mathiasekse/IELS2003_PCB/Rapport/Bilder/transmissjonslinje.jpg

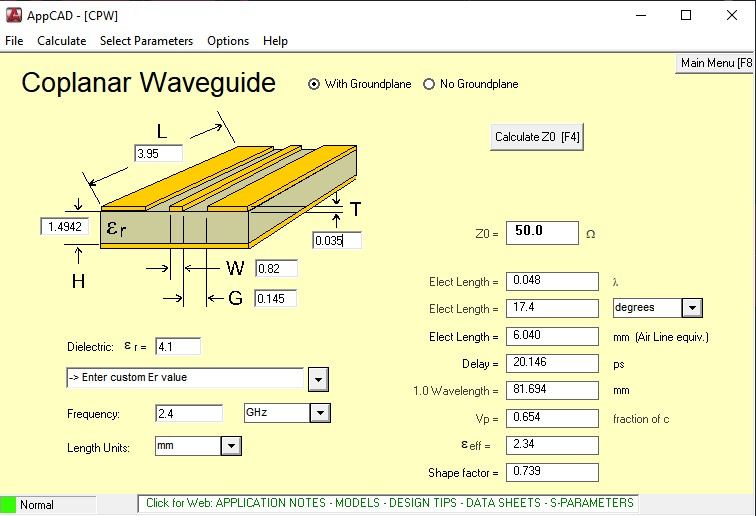
Rapport/Bilder/transmissjonslinje.jpg
