mathiasekse/IELS2003_PCB/nRF_beacon/BOM_nRF_AUDIO_BEACON.xlsx

Sheet: Grocery list
 |  |  |  |  |  |  |  |  |  | BATTERY HOLDER TOTAL
BOM |  | nRF54 BLE BEACON |  |  |  | Prosjektgruppe 15
DONE | Reference Designator | Part Number | Value | Component type | QTY | Footprint size | UNIT PRICE | TOTAL | COMMENT |  | PASSIVE TOTAL
 | C1,C6 | GRM033D80E225ME47D | 2.2 uF | PASSIVE | 2 | 0201 | kr 1.10 | kr 2.20 | Kondensator |  | kr 124.00
 | C2 | KGM05CS60J106MH | 10 uF | PASSIVE | 1 | 0402 | kr 3.19 | kr 3.19 | Kondensator
 | C3 | GRM033R70J103JA01D | 10 nF | PASSIVE | 1 | 0201 | kr 1.00 | kr 1.00 | Kondensator |  | IC TOTAL
 | C4,C8,C9,C10 | KGM03AR70J104KH | 100 nF | PASSIVE | 4 | 0201 | kr 3.60 | kr 14.40 | Kondensator |  | kr 90.00
 | C5 | GRM033R71A222KA01D | 2.2 nF | PASSIVE | 1 | 0201 | kr 1.00 | kr 1.00 | Kondensator
 | C7 | GCQ0335C1H3R9CB01D | 3.9 pF | PASSIVE | 1 | 0201 | kr 1.19 | kr 1.19 | Kondensator |  | SPEAKER TOTAL
 | C11 | GJM0335C1E1R5WB01J | 1.5 pF | PASSIVE | 1 | 0201 | kr 1.00 | kr 1.00 | Kondensator |  | kr 47.00
 | C12 | GJM0335C1E2R0WB01D | 2.0 pF | PASSIVE | 1 | 0201 | kr 1.19 | kr 1.19 | Kondensator
 | C13 | GCQ0335C1HR30BB01D | 0.3 pF | PASSIVE | 1 | 0201 | kr 1.19 | kr 1.19 | Kondensator |  | BATTERY HOLDER TOTAL
 | C14,C16,C17,C23,C24,C25 | KGM15CR51E106KT | 10 uF | PASSIVE | 6 | 0603 | kr 5.09 | kr 30.54 | Kondensator |  | kr 38.00
 | C15 | GRM188Z71C225KE43D | 2.2 uF | PASSIVE | 1 | 0603 | kr 1.60 | kr 1.60 | Kondensator
 | C18,C21,C22 | KGM03BR51E104KH | 0.1 uF | PASSIVE | 3 | 0201 | kr 1.39 | kr 4.17 | Kondensator |  | CONNECTOR TOTAL
 | C19,C20 | C0603C221J5RACTM | 220 pF | PASSIVE | 2 | 0603 | kr 1.30 | kr 2.60 | Kondensator |  | kr 21.00
 | C26 | GCQ0335C1H1R4WB01D | 1.4 pF | PASSIVE | 1 | 0201 | kr 1.80 | kr 1.80 | Kondensator
 | D1 | APGF1012GBRC-07 | LED_RGBA | PASSIVE | 1 | 1012 | kr 11.37 | kr 11.37 | LED |  | COMPONENTS TOTAL
 | FB1 | MMZ0603Y121CT000 | 120 | PASSIVE | 1 | 0201 | kr 1.30 | kr 1.30 | Ferrite Bead |  | kr 321.00
 | FB2,FB3 | BLM21SP102SN1D | 1000 | PASSIVE | 2 | 0805 | kr 2.99 | kr 5.98 | Ferrite Bead
 | J1 | FTSH-105-01-F-DV-K-P | Conn_02x05_Odd_Even | CONNECTOR | 1 | 105 | kr 21.00 | kr 21.00 | Konnektor
 | J2 |  | Conn_02x03_Counter_Clockwise |  | 1 | P2.54mm |  | kr 0.00 | Konnektor
 | L1 | LQM18PN4R7MFRL | 4.7uH | PASSIVE | 1 | 0603 | kr 1.69 | kr 1.69 | Spole
 | L2 | LQP03HQ2N7B02D | 2.7nH | PASSIVE | 1 | 0201 | kr 1.19 | kr 1.19 | Spole
 | L3,L4 | LQP03HQ3N5B02D | 3.5nH | PASSIVE | 2 | 0201 | kr 1.19 | kr 2.38 | Spole
 | L5,L6 | MLP2016V2R2MT0S1 | 2.2uH | PASSIVE | 2 | 2016 | kr 2.19 | kr 4.38 | Spole
 | LS1 | AS07104PO-R | AS07104PO-R | SPEAKER | 1 | 71x41x25mm | kr 47.21 | kr 47.21 | Høyttaler
 | R1 | CRCW0603634KDHTAP | 634k | PASSIVE | 1 | 0603 | kr 3.89 | kr 3.89 | Resistor
 | R2 | RCA02011K00FNEDSR | 1k | PASSIVE | 1 | 0201 | kr 1.00 | kr 1.00 | Resistor
 | R3,R4 | CRCW040210K0FHEDP | 10k | PASSIVE | 2 | 0402 | kr 3.19 | kr 6.38 | Resistor
 | R5,R6 | CRCW0201150KFKED | 150k | PASSIVE | 2 | 0201 | kr 2.10 | kr 4.20 | Resistor
 | U1 | NRF54L15-QFAA-R7 | nRF54L15-QFAA | IC | 1 | 6x6mm P0.4mm | kr 23.08 | kr 23.08 | MCU
 | U2 | NPM1300-QEAA-R7 | NPM1300-QEAA-R7 | IC | 1 | 5x5mm P0.5mm | kr 15.31 | kr 15.31 | PMIC
 | U3 | MAX98357AETE+T | MAX98357A | IC | 1 | 3x3mm P0.5mm | kr 51.62 | kr 51.62 | Audio DAC + Forsterker
 | U4 | 12BHC186P1-GR | 12BHC186P1-GR | BATTERY HOLDER | 1 | 12 | kr 38.28 | kr 38.28 | Batteriholder
 | X1 | CX2016DB32000D0WZRC1 | 32MHz | PASSIVE | 1 | 2016 | kr 6.59 | kr 6.59 | Krystall
 | X2 | CM8V-T1A-32.768kHz-9pF-20PPM-TB-QC | 32.768 kHz | PASSIVE | 1 | 2012-2Pin | kr 6.59 | kr 6.59 | Krystall

Sheet: calculations
*** Sheet to remain hidden ***
 |  |  |  |  |  |  | kr 0.00 | kr 0.00 | OTHER TOTAL
 |  |  |  |  |  |  |  | kr 321.00 | COMPONENTS TOTAL
 | PASSIVE | 124.002 | 124.002006 | 124.002006 | 1 | PASSIVE | kr 124.00 | kr 124.00 | PASSIVE TOTAL
 | CONNECTOR | 21 | 21.000007 | 90.01001 | 5 | IC | kr 90.01 | kr 90.00 | IC TOTAL
 | 0 | 0 | 8e-06 | 47.210009 | 4 | SPEAKER | kr 47.21 | kr 47.00 | SPEAKER TOTAL
 | SPEAKER | 47.21 | 47.210009 | 38.280011 | 6 | BATTERY HOLDER | kr 38.28 | kr 38.00 | BATTERY HOLDER TOTAL
 | IC | 90.01 | 90.01001 | 21.000007 | 2 | CONNECTOR | kr 21.00 | kr 21.00 | CONNECTOR TOTAL
 | BATTERY HOLDER | 38.28 | 38.280011 | 2.1e-05 | 16 |  | kr 0.00
 |  | 0 | 1.2e-05
 |  | 0 | 1.3e-05
 |  | 0 | 1.4e-05
 |  | 0 | 1.5e-05
 |  | 0 | 1.6e-05
 |  | 0 | 1.7e-05
 |  | 0 | 1.8e-05
 |  | 0 | 1.9e-05
 |  | 0 | 2e-05
 |  | 0 | 2.1e-05
