mathiasekse/IELS2003_PCB/symbols_footprints/nPM1300-QEAA-Reference-Layout-1_2/Bill of Materials/npm1300_qeaa_config2_bom.xlsx

Bill of Materials
Device: | nPM1300-QEAA
Configuration No.: | 2
Reference Layout Title: | Simple – one BUCK, LOADSW and LED
Revision: | 1.2
Creation Date: | 2025-06-05
Designator | Value | Description | Footprint Doc | Manufacturer | Manufacturer Part Number | #Column Name Error:' Fitted | Quantity
C1, C5, C14 | 1.0µF | Capacitor, Ceramic, 1.0µF 10V X5R 0603,±10% | 0603 | N.A. | N.A. |  | 3
C2, C4, C7 | 10µF | Capacitor, Ceramic, X5R, ±20%, 10V | 0603 | N.A. | N.A. |  | 3
C6 | 2.2µF | Capacitor, Ceramic, X5R, ±10%, 25V | 0603 | Murata | GRM188R61E225KA12D |  | 1
C13 | 100nF | Capacitor, Ceramic, X5R, ±10%, 25V | 0201 | Murata | GRM033R61E104KE14J |  | 1
L1 | 2.2µH | Inductor, Irms=2.5A, Isat=2.9A, ±20%, DCR=73mΩ | 0806 | Samsung Electro-Mechanics America | CIGT201610EH2R2MNE |  | 1
R1, R2 | 10k | Resistor, ±1%, 0.05W | 0201 | N.A. | N.A. |  | 2
R3 | 47k | Resistor, ±1%, 0.05W | 0201 | N.A. | N.A. |  | 1
U1 | nPM1300-QEAA | Li-Ion/Li-Polymer USB-C battery charger with high efficiency buck regulators, LDOs or load switches, LED drivers, TWI and VBUSOUT | QFN-32 | Nordic Semiconductor | nPM1300-QEAA |  | 1
 |  |  |  |  |  |  | 13
