mathiasekse/IELS2003_PCB/symbols_footprints/nPM1300-QEAA-Reference-Layout-1_2/Bill of Materials/npm1300_qeaa_config3_bom.xlsx

Bill of Materials
Device: | nPM1300-QEAA
Configuration No.: | 3
Reference Layout Title: | Minimal – only battery charging and VSYS output
Revision: | 1.2
Creation Date: | 2025-06-05
Designator | Value | Description | Footprint Doc | Manufacturer | Manufacturer Part Number | #Column Name Error:' Fitted | Quantity
C1, C5 | 1.0µF | Capacitor, Ceramic, 1.0µF 10V X5R 0603,±10% | 0603 | N.A. | N.A. |  | 2
C4 | 10µF | Capacitor, X5R, ±20% | 0603 | N.A. | N.A. |  | 1
C6 | 2.2µF | Capacitor, Ceramic, X7R, ±10%, 16V | 0603 | Taiyo Yuden | EMK107BB7225KA-T |  | 1
C13 | 100nF | Capacitor, X5R, ±10%, 100nF, 16V | 0201 | N.A. | N.A. |  | 1
R1, R2 | 10k | Resistor, ±1%, 0.05W | 0201 | N.A. | N.A. |  | 2
U1 | nPM1300-QEAA | Li-Ion/Li-Polymer USB-C battery charger with high efficiency buck regulators, LDOs or load switches, LED drivers, TWI and VBUSOUT | QFN-32 | Nordic Semiconductor | nPM1300-QEAA |  | 1
 |  |  |  |  |  |  | 8
