mathiasekse/IELS2003_PCB/symbols_footprints/nrf54l15-qfaa-reference-layout-0_8/nRF54L15-QFAA Reference Layout 0_8/Bill of Materials/nRF54L15_qfaa_4L_config1_bom.xls

Bill of material
Device: | nRF54L15-QFAA
Title: | Reference Layout
Version: | v0.8
Designator | Value | Description | Assembly | Footprint Doc
C1, C2 | 2.2µF | Capacitor, Ceramic, 2.2µF 2.5V X6T 0201,±20% |  | 0201
C3 | 10µF | Capacitor, X6S, ±20%, 6.3V |  | 0402
C4, C7, C8, C10 | 100nF | Capacitor, X7R, ±10% |  | 0201
C5 | 2.2nF | Capacitor, X7R, ±10%, 10V |  | 0201
C6 | 1.5pF | Capacitor, NP0, ±0.05pF, 25V |  | 0201
C9 | 2.0pF | Capacitor, NP0, ±0.05pF, 25V |  | 0201
C11 | 0.3pF | Capacitor, C0G, ±0.1pF, 50V |  | 0201
C12 | 10nF | Capacitor, X7R, 6.3V |  | 0201
C13 | 3.9pF | Capacitor, NP0, ±0.05pF, 25V |  | 0201
FB1 | 120R/0.2A | Ferrite Bead, 120 Ohm @ 100MHz, 200mA, 500 mOhm Max |  | 0201
L1 | 4.7µH | Inductor, 120mA, ±20%, 0.65R |  | 0603
L2 | 2.7nH | Inductor, 600mA, ±0.1ｎH, 120mOhm |  | 0201
L3, L4 | 3.5nH | Inductor, 500mA, ±0.1ｎH, 170mOhm |  | 0201
R1 | 1k | Resistor, ±1%, 0.05W |  | 0201
U1 | nRF54L15-QFAA | Multi-protocol Bluetooth Low Energy, IEEE 802.15.4 and 2.4GHz proprietary Wireless MCU |  | QFN-48
X1 | 32.768kHz | XTAL SMD 2012, 32.768kHz, 9pF, ±20ppm |  | XTAL_2012
X2 | 32MHz | XTAL SMD 2016, 32MHz, Cl=8pF, Tot: ±40ppm |  | XTAL_2016
