mathiasekse/IELS2003_PCB/nRF_beacon/nRF_beacon.step

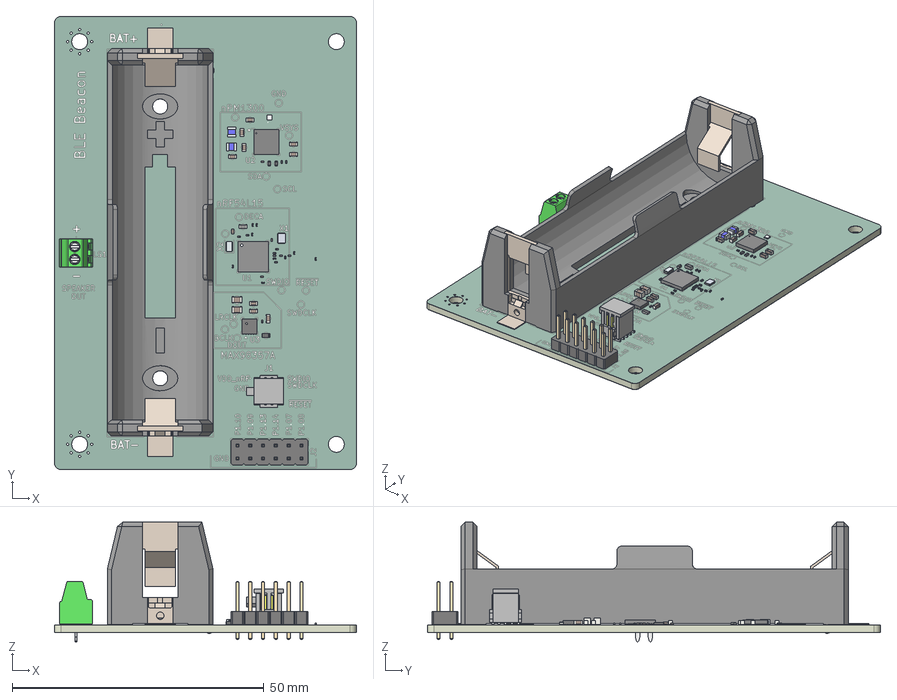
[picture p2: CAD file, 2026-03-08]
nRF_beacon/nRF_beacon.step
60.0 x 90.0 x 23.7 mm
C_0603_1608Metric x 9
C_0201_0603Metric x 16
R_0201_0603Metric x 3
C_0402_1005Metric
L_0201_0603Metric x 4
R_0402_1005Metric x 2
term1 x 4
term2 x 4
NRF54L15-QFAA-R
APGF1012GBRC-07
TQFN-16-1EP_3x3mm_P0.5mm_EP1.6x1.6mm
L_0603_1608Metric
QFN32_5X5_NOR
C_0805_2012Metric x 2
R_0603_1608Metric
CX2016DB32000D0WZRC1
Terminal
FTSH-105-01-L-DV-K-P-TR_pp_pad
FTSH-105-01-L-DV-K-P-TR_pins2
FTSH-105-01-L-DV-K-P-TR_pins1
FTSH-105-01-L-DV-K-P-TR_body
12BHC186P1-GR
VN02A1500000G
PinHeader_2x06_P2.54mm_Vertical
nRF_beacon_silkscreen x 2
nRF_beacon_soldermask x 2
nRF_beacon_PCB
