mathiasekse/IELS2003_PCB/symbols_footprints/CX2016DB32000D0WZRC1/3D/CX2016DB32000D0WZRC1.stp

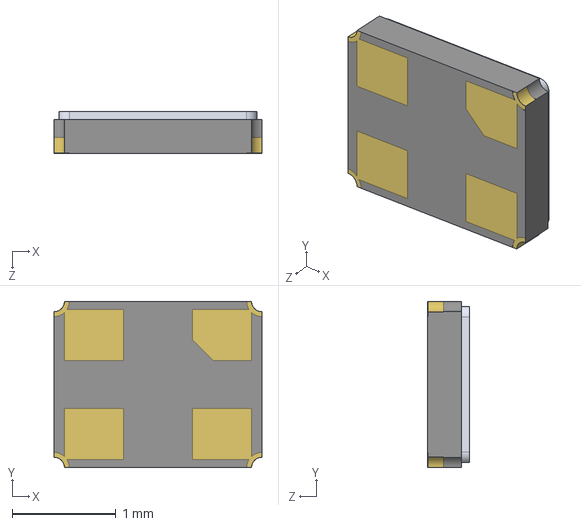
[picture p3: CAD file, 2026-02-28]
symbols_footprints/CX2016DB32000D0WZRC1/3D/CX2016DB32000D0WZRC1.stp
2.00 x 1.60 x 0.4 mm
