mathiasekse/IELS2003_PCB/(list of files, cad)

Other CAD files:
nRF_beacon/nRF_beacon.stl
symbols_footprints/APGF1012GBRC-07/Allegro/apgf1012gbrc07.psm
symbols_footprints/APGF1012GBRC-07/DEHDL/apgf1012gbrc_07/chips/chips.prt
symbols_footprints/CX2016DB32000D0WZRC1/Allegro/cx2016db32000d0wzrc1.psm
symbols_footprints/CX2016DB32000D0WZRC1/DEHDL/cx2016db32000d0wzrc1/chips/chips.prt
