mathiasekse/IELS2003_PCB/(list of files, drawings)

Other design files:
symbols_footprints/APGF1012GBRC-07/Altium/APGF1012GBRC07.PcbLib
symbols_footprints/APGF1012GBRC-07/Altium/APGF1012GBRC-07.SchLib
symbols_footprints/CX2016DB32000D0WZRC1/Altium/CX2016DB32000D0WZRC1.PcbLib
symbols_footprints/CX2016DB32000D0WZRC1/Altium/CX2016DB32000D0WZRC1.SchLib
symbols_footprints/nPM1300-QEAA-Reference-Layout-1_2/Altium Designer files/npm1300_qeaa_config1.PcbDoc
symbols_footprints/nPM1300-QEAA-Reference-Layout-1_2/Altium Designer files/npm1300_qeaa_config1.PrjPCB
symbols_footprints/nPM1300-QEAA-Reference-Layout-1_2/Altium Designer files/npm1300_qeaa_config1.SchDoc
symbols_footprints/nPM1300-QEAA-Reference-Layout-1_2/Altium Designer files/npm1300_qeaa_config2.PcbDoc
symbols_footprints/nPM1300-QEAA-Reference-Layout-1_2/Altium Designer files/npm1300_qeaa_config2.PrjPCB
symbols_footprints/nPM1300-QEAA-Reference-Layout-1_2/Altium Designer files/npm1300_qeaa_config2.SchDoc
symbols_footprints/nPM1300-QEAA-Reference-Layout-1_2/Altium Designer files/npm1300_qeaa_config3.PcbDoc
symbols_footprints/nPM1300-QEAA-Reference-Layout-1_2/Altium Designer files/npm1300_qeaa_config3.PrjPCB
symbols_footprints/nPM1300-QEAA-Reference-Layout-1_2/Altium Designer files/npm1300_qeaa_config3.SchDoc
symbols_footprints/nPM1300-QEAA-Reference-Layout-1_2/Altium Designer files/npm1300_qeaa_config4.PcbDoc
symbols_footprints/nPM1300-QEAA-Reference-Layout-1_2/Altium Designer files/npm1300_qeaa_config4.PrjPCB
symbols_footprints/nPM1300-QEAA-Reference-Layout-1_2/Altium Designer files/npm1300_qeaa_config4.SchDoc
symbols_footprints/nrf54l15-qfaa-reference-layout-0_8/nRF54L15-QFAA Reference Layout 0_8/Altium Designer files/nRF54L15_qfaa_4L_config1.PcbDoc
symbols_footprints/nrf54l15-qfaa-reference-layout-0_8/nRF54L15-QFAA Reference Layout 0_8/Altium Designer files/nRF54L15_qfaa_4L_config1.PrjPCB
symbols_footprints/nrf54l15-qfaa-reference-layout-0_8/nRF54L15-QFAA Reference Layout 0_8/Altium Designer files/nRF54L15_qfaa_4L_config1.SchDoc
