mathiasekse/IELS2003_PCB/nRF_beacon/nRF_beacon.kicad_pcb

## KiCad design nRF_beacon/nRF_beacon.kicad_pcb (2026-03-08)

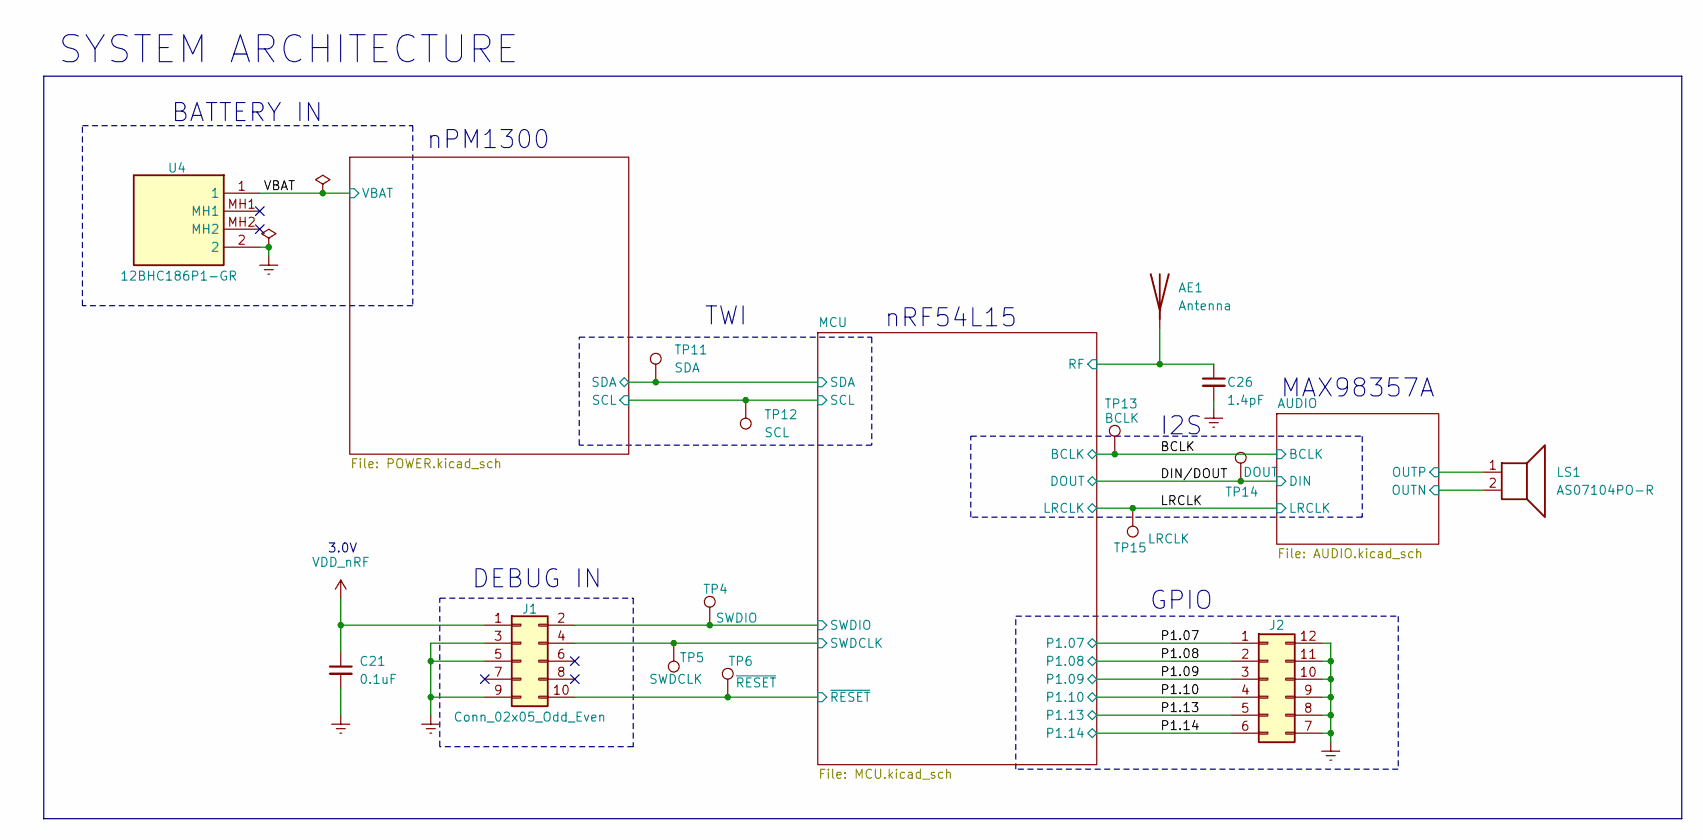
[picture p4: schematic nRF_beacon.kicad_sch, nRF54L15 BLE Sound Beacon]

Parts:
AE1: Antenna; PCB_Antenna
C21: 0.1uF; C_0201_0603Metric; MPN KGM03BR51E104KH
C26: 1.4pF; C_0201_0603Metric; MPN GCQ0335C1H1R4WB01D
J1: Conn_02x05_Odd_Even; FTSH-105-XX-YYY-DV-K-P-TR; MPN FTSH-105-01-F-DV-K-P
J2: Conn_02x03_Counter_Clockwise; PinHeader_2x06_P2.54mm_Vertical
LS1: AS07104PO-R; VN02A1500000G; MPN AS07104PO-R
TP4: SWDIO; TestPoint_Pad_D1.0mm
TP5: SWDCLK; TestPoint_Pad_D1.0mm
TP6: ~{RESET}; TestPoint_Pad_D1.0mm
TP11: SDA; TestPoint_Pad_D1.0mm
TP12: SCL; TestPoint_Pad_D1.0mm
TP13: BCLK; TestPoint_Pad_D1.0mm
TP14: DOUT; TestPoint_Pad_D1.0mm
TP15: LRCLK; TestPoint_Pad_D1.0mm
U4: 12BHC186P1-GR; 12BHC186P1GR; Manufacturer_Part_Number 12BHC186P1-GR; Mouser Part Number 12BHC186P1-GR

Connections:
/AUDIO/OUTN: LS1.2; also elsewhere on the board
/AUDIO/OUTP: LS1.1; also elsewhere on the board
/BCLK: TP13.1; also elsewhere on the board
/DIN/DOUT: TP14.1; also elsewhere on the board
/LRCLK: TP15.1; also elsewhere on the board
/MCU/RF: AE1.1 (A), C26.1; also elsewhere on the board
/MCU/SCL: TP12.1; also elsewhere on the board
/MCU/SDA: TP11.1; also elsewhere on the board
/MCU/SWDCLK: J1.4, TP5.1; also elsewhere on the board
/MCU/SWDIO: J1.2, TP4.1; also elsewhere on the board
/MCU/~RESET: J1.10, TP6.1; also elsewhere on the board
/P1.07: J2.1; also elsewhere on the board
/P1.08: J2.2; also elsewhere on the board
/P1.09: J2.3; also elsewhere on the board
/P1.10: J2.4; also elsewhere on the board
/P1.13: J2.5; also elsewhere on the board
/P1.14: J2.6; also elsewhere on the board
/VBAT: U4.1; also elsewhere on the board
GND: C21.2, C26.2, J1.3, J1.5, J1.9, J2.7, J2.8, J2.9, J2.10, J2.11, J2.12, U4.2; also elsewhere on the board
VDD_nRF: C21.1, J1.1; also elsewhere on the board

Notes on the sheet:
nPM1300
DEBUG IN
BATTERY IN
I2S
3.0V
GPIO
nRF54L15
TWI
SYSTEM ARCHITECTURE
MAX98357A

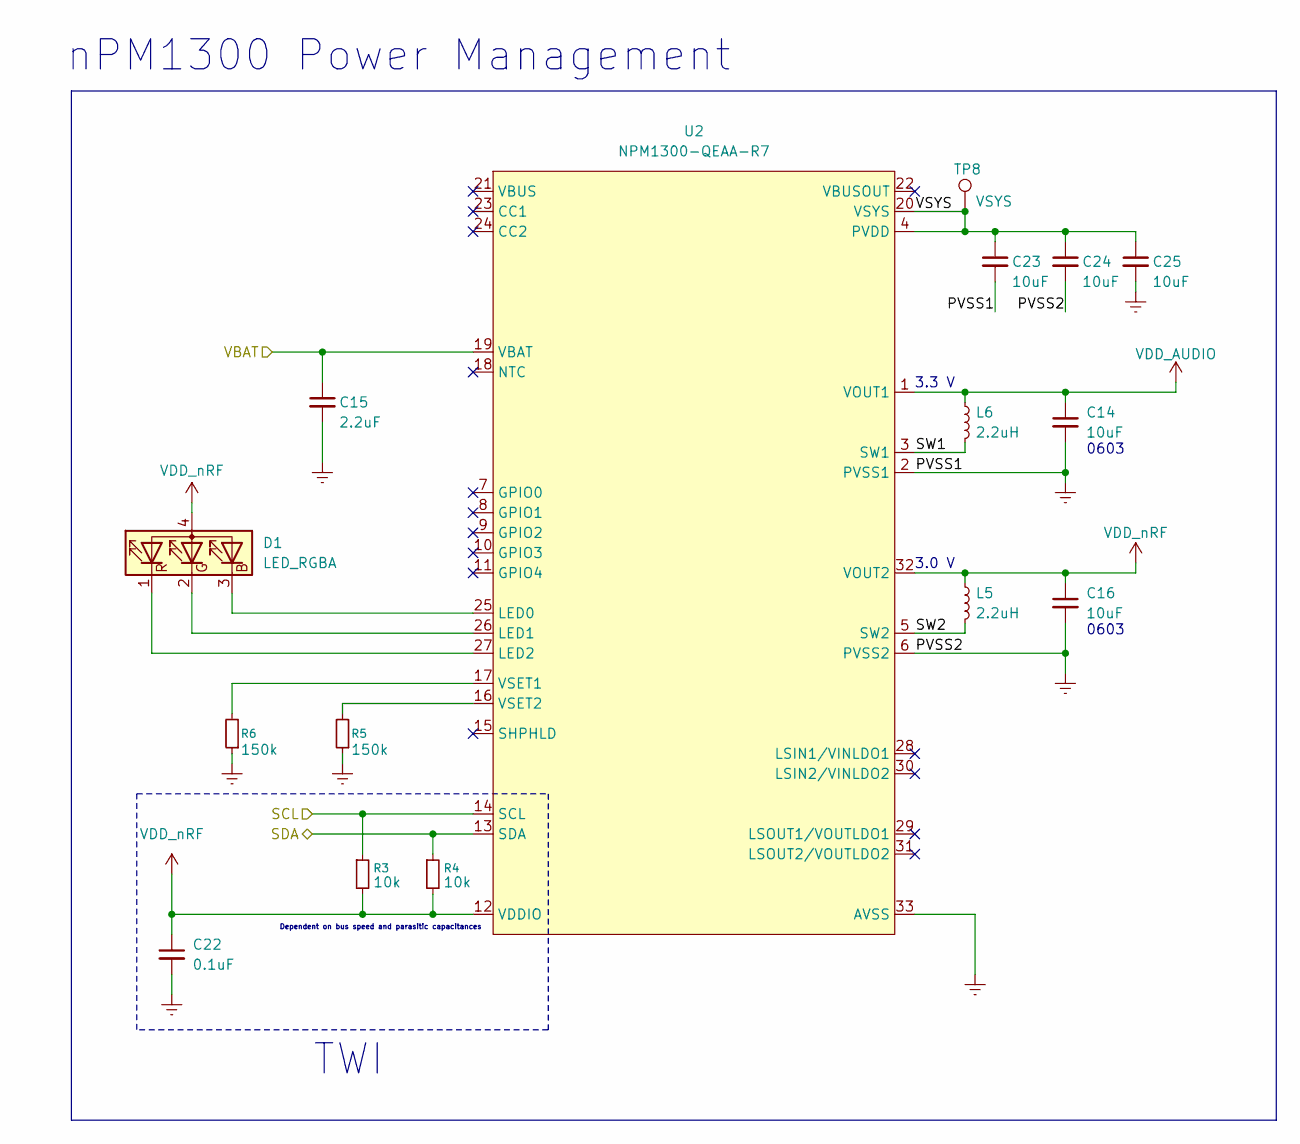
[picture p5: schematic POWER.kicad_sch, Power Management (nPM1300)]

Parts:
C14, C16, C23, C24, C25: 10uF; C_0603_1608Metric; MPN KGM15CR51E106KT
C15: 2.2uF; C_0603_1608Metric; MPN GRM188Z71C225KE43D
C22: 0.1uF; C_0201_0603Metric; MPN KGM03BR51E104KH
D1: LED_RGBA; APGF1012GBRC07; MPN APGF1012GBRC-07
L5, L6: 2.2uH; INDC2016X100N; MPN MLP2016V2R2MT0S1
R3, R4: 10k; R_0402_1005Metric; MPN CRCW040210K0FHEDP
R5, R6: 150k; R_0201_0603Metric; MPN CRCW0201150KFKED
TP8: VSYS; TestPoint_Pad_D1.0mm
U2: NPM1300-QEAA-R7; QFN-32_EP_5x5_Pitch0.5mm; MPN NPM1300-QEAA-R7

Connections:
/MCU/SCL: R3.1, U2.14 (SCL); also elsewhere on the board
/MCU/SDA: R4.1, U2.13 (SDA); also elsewhere on the board
/POWER/SW1: L6.2, U2.3 (SW1)
/POWER/SW2: L5.2, U2.5 (SW2)
/POWER/VSYS: C23.1, C24.1, C25.1, TP8.1, U2.4 (PVDD), U2.20 (VSYS)
/VBAT: C15.1, U2.19 (VBAT); also elsewhere on the board
GND: C14.2, C15.2, C16.2, C22.2, C23.2, C24.2, C25.2, R5.1, R6.1, U2.2 (PVSS1), U2.6 (PVSS2), U2.33 (AVSS); also elsewhere on the board
unnamed: D1.3 (BK), U2.25 (LED0)
unnamed: D1.2 (GK), U2.26 (LED1)
unnamed: D1.1 (RK), U2.27 (LED2)
unnamed: R6.2, U2.17 (VSET1)
unnamed: R5.2, U2.16 (VSET2)
VDD_AUDIO: C14.1, L6.1, U2.1 (VOUT1); also elsewhere on the board
VDD_nRF: C16.1, C22.1, D1.4 (A), L5.1, R3.2, R4.2, U2.12 (VDDIO), U2.32 (VOUT2); also elsewhere on the board

Notes on the sheet:
0603
TWI
3.3 V
nPM1300 Power Management
Dependent on bus speed and parasitic capacitances
3.0 V

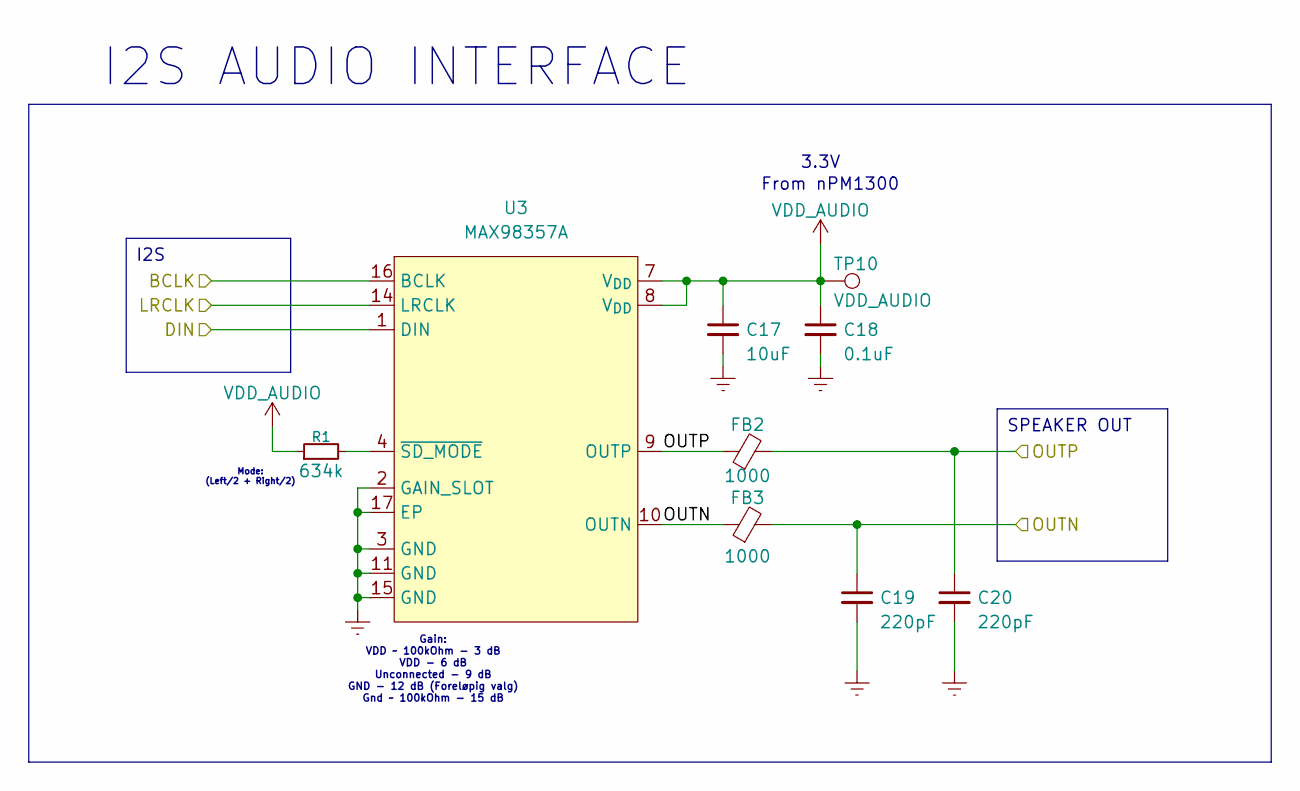
[picture p6: schematic AUDIO.kicad_sch, I2S Audio Output]

Parts:
C17: 10uF; C_0603_1608Metric; MPN KGM15CR51E106KT
C18: 0.1uF; C_0201_0603Metric; MPN KGM03BR51E104KH
C19, C20: 220pF; C_0603_1608Metric; MPN C0603C221J5RACTM
FB2, FB3: 1000; C_0805_2012Metric; MPN BLM21SP102SN1D
R1: 634k; R_0603_1608Metric; MPN CRCW0603634KDHTAP
TP10: VDD_AUDIO; TestPoint_Pad_D1.0mm
U3: MAX98357A; TQFN-16-1EP_3x3mm_P0.5mm_EP1.6x1.6mm; MPN MAX98357AETE+T

Connections:
/AUDIO/OUTN: C19.1, FB3.1, FB3.2, U3.10 (OUTN); also elsewhere on the board
/AUDIO/OUTP: C20.1, FB2.1, FB2.2, U3.9 (OUTP); also elsewhere on the board
/BCLK: U3.16 (BCLK); also elsewhere on the board
/DIN/DOUT: U3.1 (DIN); also elsewhere on the board
/LRCLK: U3.14 (LRCLK); also elsewhere on the board
GND: C17.2, C18.2, C19.2, C20.2, U3.2 (GAIN_SLOT), U3.3 (GND), U3.11 (GND), U3.15 (GND), U3.17 (EP); also elsewhere on the board
unnamed: R1.2, U3.4 (~SD_MODE)
VDD_AUDIO: C17.1, C18.1, R1.1, TP10.1, U3.7 (V_{DD}), U3.8 (V_{DD}); also elsewhere on the board

Notes on the sheet:
Gain: VDD ~ 100kOhm - 3 dB VDD - 6 dB Unconnected - 9 dB GND - 12 dB (Foreløpig valg) Gnd ~ 100kOhm - 15 dB
Mode: (Left/2 + Right/2)
From nPM1300
I2S AUDIO INTERFACE
3.3V
SPEAKER OUT
I2S

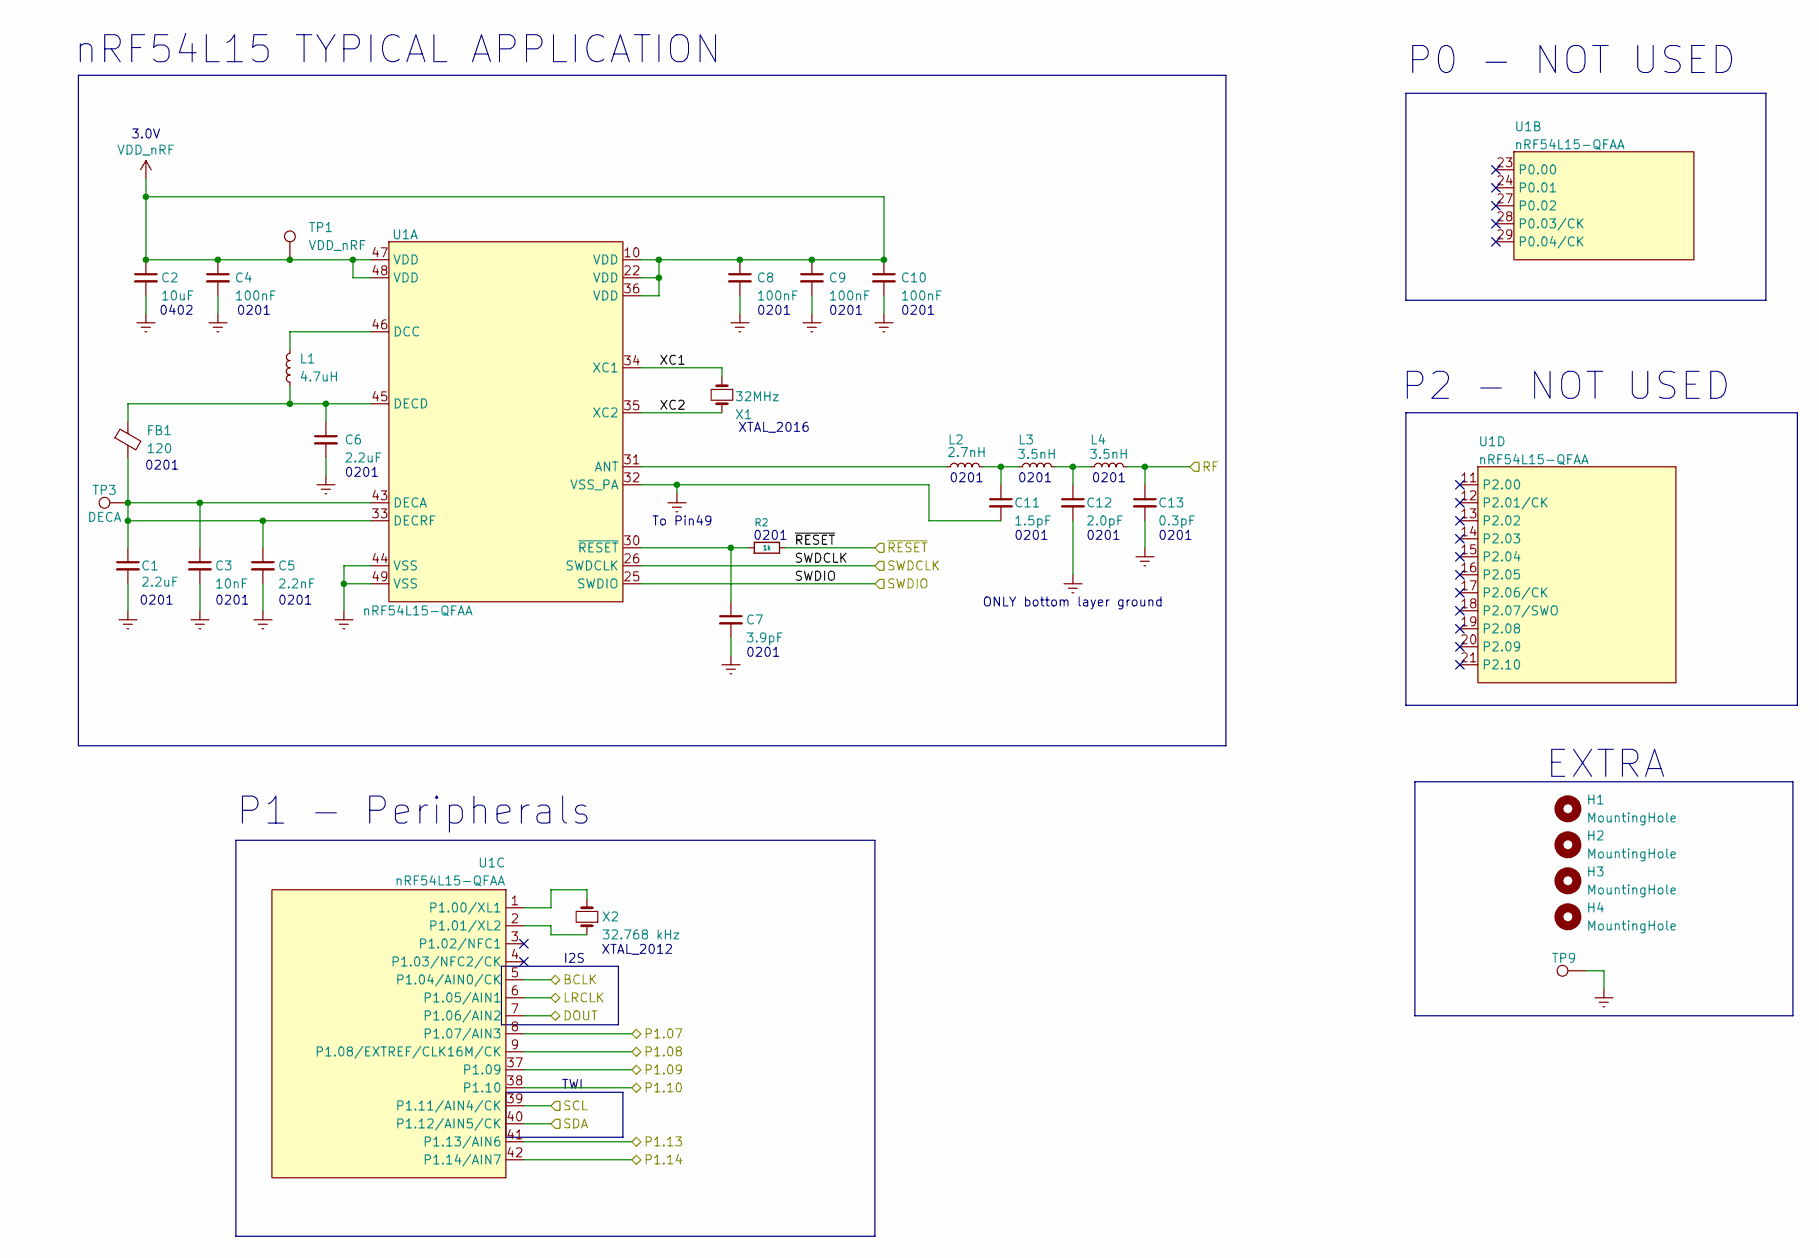
[picture p7: schematic MCU.kicad_sch, nRF54L15 MCU and RF Section]

Parts:
C1, C6: 2.2uF; C_0201_0603Metric; MPN GRM033D80E225ME47D
C2: 10uF; C_0402_1005Metric; MPN KGM05CS60J106MH
C3: 10nF; C_0201_0603Metric; MPN GRM033R70J103JA01D
C4, C8, C9, C10: 100nF; C_0201_0603Metric; MPN KGM03AR70J104KH
C5: 2.2nF; C_0201_0603Metric; MPN GRM033R71A222KA01D
C7: 3.9pF; C_0201_0603Metric; MPN GCQ0335C1H3R9CB01D
C11: 1.5pF; C_0201_0603Metric; MPN GJM0335C1E1R5WB01J
C12: 2.0pF; C_0201_0603Metric; MPN GJM0335C1E2R0WB01D
C13: 0.3pF; C_0201_0603Metric; MPN GCQ0335C1HR30BB01D
FB1: 120; L_0201_0603Metric; MPN MMZ0603Y121CT000
H1, H2: MountingHole; MountingHole_3.2mm_M3_Pad_Via
H3, H4: MountingHole; MountingHole_3.2mm_M3
L1: 4.7uH; L_0603_1608Metric; MPN LQM18PN4R7MFRL
L2: 2.7nH; L_0201_0603Metric; MPN LQP03HQ2N7B02D
L3, L4: 3.5nH; L_0201_0603Metric; MPN LQP03HQ3N5B02D
R2: 1k; R_0201_0603Metric; MPN RCA02011K00FNEDSR
TP1: VDD_nRF; TestPoint_Pad_D1.0mm
TP3: DECA; TestPoint_Pad_D1.0mm
TP9: GND; TestPoint_Pad_D1.0mm
U1: nRF54L15-QFAA; QFN-48_EP_6x6_Pitch0.4mm; MPN NRF54L15-QFAA-R7
X1: 32MHz; CX2016DB32000D0WZRC1; MPN CX2016DB32000D0WZRC1
X2: 32.768 kHz; Crystal_SMD_2012-2Pin_2.0x1.2mm; MPN CM8V-T1A-32.768kHz-9pF-20PPM-TB-QC

Connections:
/BCLK: U1.5 (P1.04/AIN0/CK); also elsewhere on the board
/DIN/DOUT: U1.7 (P1.06/AIN2); also elsewhere on the board
/LRCLK: U1.6 (P1.05/AIN1); also elsewhere on the board
/MCU/RF: C13.1, L4.2; also elsewhere on the board
/MCU/SCL: U1.39 (P1.11/AIN4/CK); also elsewhere on the board
/MCU/SDA: U1.40 (P1.12/AIN5/CK); also elsewhere on the board
/MCU/SWDCLK: U1.26 (SWDCLK); also elsewhere on the board
/MCU/SWDIO: U1.25 (SWDIO); also elsewhere on the board
/MCU/XC1: U1.34 (XC1), X1.1
/MCU/XC2: U1.35 (XC2), X1.3
/MCU/~RESET: R2.2; also elsewhere on the board
/P1.07: U1.8 (P1.07/AIN3); also elsewhere on the board
/P1.08: U1.9 (P1.08/EXTREF/CLK16M/CK); also elsewhere on the board
/P1.09: U1.37 (P1.09); also elsewhere on the board
/P1.10: U1.38 (P1.10); also elsewhere on the board
/P1.13: U1.41 (P1.13/AIN6); also elsewhere on the board
/P1.14: U1.42 (P1.14/AIN7); also elsewhere on the board
GND: C1.2, C2.2, C3.2, C4.2, C5.2, C6.2, C7.2, C8.2, C9.2, C10.2, C11.2, C12.2, C13.2, TP9.1, U1.32 (VSS_PA), U1.44 (VSS), U1.49 (VSS), X1.2, X1.4; also elsewhere on the board
unnamed: C11.1, L2.2, L3.1
unnamed: C12.1, L3.2, L4.1
unnamed: L2.1, U1.31 (ANT)
unnamed: L1.2, U1.46 (DCC)
unnamed: C1.1, C3.1, C5.1, FB1.2, TP3.1, U1.33 (DECRF), U1.43 (DECA)
unnamed: C6.1, FB1.1, L1.1, U1.45 (DECD)
unnamed: C7.1, R2.1, U1.30 (~RESET)
unnamed: U1.1 (P1.00/XL1), X2.2
unnamed: U1.2 (P1.01/XL2), X2.1
VDD_nRF: C2.1, C4.1, C8.1, C9.1, C10.1, TP1.1, U1.10 (VDD), U1.22 (VDD), U1.36 (VDD), U1.47 (VDD), U1.48 (VDD); also elsewhere on the board

Notes on the sheet:
0201
3.0V
XTAL_2012
P0 - NOT USED
0402
0201
XTAL_2016
nRF54L15 TYPICAL APPLICATION
P2 - NOT USED
TWI
P1 - Peripherals
ONLY bottom layer ground
EXTRA
To Pin49
I2S

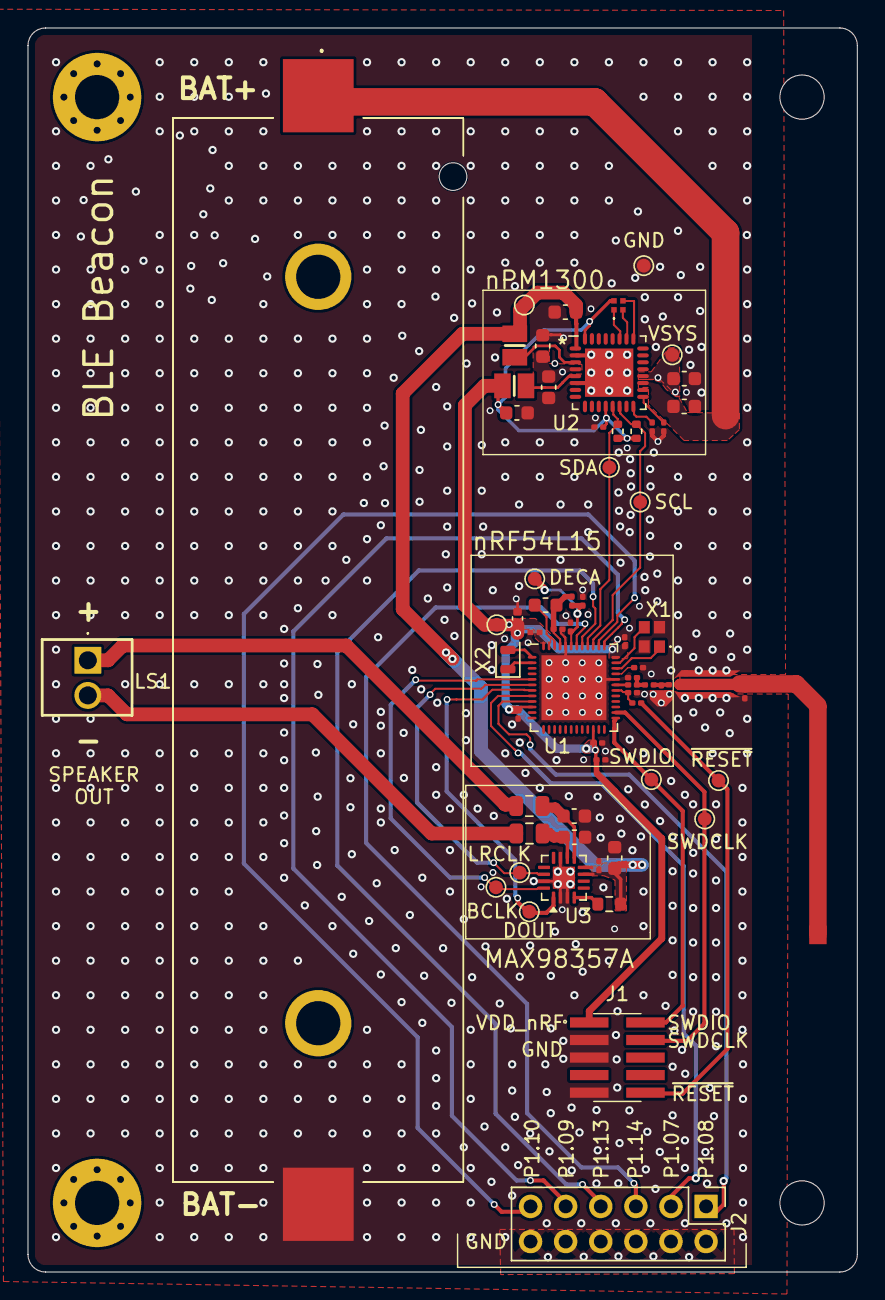
[picture p8: board nRF_beacon.kicad_pcb from above]

Board: 4 copper layers, 60.0 x 90.0 mm, 69 parts (0 on the bottom side), 41 nets.
