mathiasekse/IELS2003_PCB/symbols_footprints/nPM1300-QEAA-Reference-Layout-1_2/Altium Designer files/npm1300_qeaa_config1/npm1300_qeaa_config1.kicad_pcb

## KiCad design symbols_footprints/nPM1300-QEAA-Reference-Layout-1_2/Altium Designer files/npm1300_qeaa_config1/npm1300_qeaa_config1.kicad_pcb (2026-03-02)

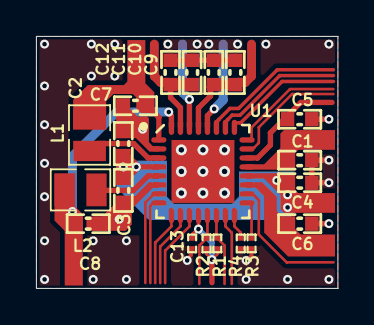
[picture p9: board npm1300_qeaa_config1.kicad_pcb from above]

Board: 4 copper layers, 16.8 x 14.0 mm, 22 parts (0 on the bottom side), 18 nets.

Parts:
C1, C5: 1.0µF; CAPC1608X06L
C2, C3, C4, C7, C8, C9, C10, C11, C12: 10µF; CAPC1608X06L
C6: 2.2µF; CAPC1608X06L
C13: 100nF; CAPC0603X03L_C
L1, L2: 2.2µH; INDC2016X10N
NT1, NT2: Net tie; 2 PIN STARPOINT
R1, R2: 10k; RESC0603X03L_C
R3: 47k; RESC0603X03L_C
R4: 150k; RESC0603X03L_C
U1: nPM1300-QEAA; Nordic_QFN50P500X500X90-33N

Connections:
GND: C1.1, C4.1, C5.1, C6.1, C9.1, C10.1, C11.1, C12.1, C13.2, NT1.1, NT2.1, R3.2, R4.2, U1.33
PVSS1: C2.1, C7.1, NT1.2, U1.2
PVSS2: C3.1, C8.1, NT2.2, U1.6
SCL: R1.1, U1.14
SDA: R2.1, U1.13
SW1: L1.2, U1.3
SW2: L2.2, U1.5
VBAT: C6.2, U1.19
VBUSIN: C1.2, U1.21
VBUSOUT: C5.2, U1.22
VDDIO: C13.1, R1.2, R2.2, U1.12
VOUT1: C7.2, L1.1, U1.1
VOUT2: C8.2, L2.1, U1.32
VOUTLDO1: C9.2, C10.2, U1.29
VOUTLDO2: C11.2, C12.2, U1.31
VSET1: R3.1, U1.17
VSET2: R4.1, U1.16
VSYS: C2.2, C3.2, C4.2, U1.4, U1.20
