mathiasekse/IELS2003_PCB/(commit log)

2026-02-09 Opprettet prosjektfiler
    [nRF_beacon.kicad_pcb, nRF_beacon.kicad_sch]
2026-02-09 Lagt inn referanselayout for nRF54L15 (unntatt antenne matching network)
    [nRF_beacon.kicad_sch]
2026-02-10 Lagt til symbol og footprint filer til nRF54L15
    [NRF54L15-QFAA-R.step, nRF54L15_qfaa_4L_config1.PcbDoc, nRF54L15_qfaa_4L_config1.PrjPCB, nRF54L15_qfaa_4L_config1.SchDoc, nRF54L15_qfaa_4L_config1_bom.xls]
2026-02-10 Added I2S audio interface schematic
    [nRF_beacon.kicad_sch]
2026-02-11 Added footprint and model for nRF and nPM
    [nRF_beacon.kicad_sch]
2026-02-11 Added reference layout files from Nordic for nPM1300 PMIC
    [npm1300_qeaa_config1.DRL, npm1300_qeaa_config1.GBL, npm1300_qeaa_config1.GBO, npm1300_qeaa_config1.GBP, npm1300_qeaa_config1.GBS, npm1300_qeaa_config1.GM1, npm1300_qeaa_config1.GTL, npm1300_qeaa_config1.GTO]
2026-02-11 Created new symbol for nPM1300
    [nRF_beacon.kicad_sch]
2026-02-11 Added hierchical sheets for simple block diagram on root page, with complex circuits on their own page
    [AUDIO.kicad_sch, MCU.kicad_sch, POWER.kicad_sch, nRF_beacon.kicad_sch]
2026-02-13 Finished typical application nRF. Added audio-block in root sheet.
    [AUDIO.kicad_sch, MCU.kicad_sch, nRF_beacon.kicad_sch]
2026-02-13 small optimizations in root schematics
    [nRF_beacon.kicad_sch]
2026-02-14 Added MPN and footprints for all components on nRF general application
    [AUDIO.kicad_sch, MCU.kicad_sch, POWER.kicad_sch, nRF_beacon.kicad_pcb, nRF_beacon.kicad_sch]
2026-02-16 Added buck configuration for AUDIO 3.3V power. Removed USB input
    [AUDIO.kicad_sch, MCU.kicad_sch, POWER.kicad_sch, nRF_beacon.kicad_sch]
2026-02-17 Updated nPM schematic. Added TWI and debug connector
    [AUDIO.kicad_sch, MCU.kicad_sch, POWER.kicad_sch, nRF_beacon.csv, nRF_beacon.kicad_pcb, nRF_beacon.kicad_sch]
2026-02-23 Added LEDs and BUCK supply from VSYS
    [MCU.kicad_sch, POWER.kicad_sch, nRF_beacon.kicad_sch]
2026-02-23 Finished first schematic draft. Ready for layout
    [APGF1012GBRC-07.SchLib, APGF1012GBRC07.PcbLib, AUDIO.kicad_sch, EDI2CAP.CFG, MCU.kicad_sch, POWER.kicad_sch, apgf1012gbrc07.psm, chips.prt]
2026-02-23 Roughly grouped components by function in PCB-layout
    [nRF_beacon.kicad_pcb]
2026-02-26 Began matching network layout
    [AUDIO.kicad_sch, MCU.kicad_sch, POWER.kicad_sch, nRF_beacon.kicad_pcb, nRF_beacon.kicad_sch]
2026-02-28 Added most of the components to nRF54 typical application layout
    [AUDIO.kicad_sch, CX2016DB32000D0WZRC1.PcbLib, CX2016DB32000D0WZRC1.SchLib, CX2016DB32000D0WZRC1.stp, EDI2CAP.CFG, MCU.kicad_sch, POWER.kicad_sch, chips.prt]
2026-02-28 Adjusted antenna layout
    [nRF_beacon.kicad_pcb]
2026-03-01 Added transmission line, and new folder for report screenshots
    [POWER.kicad_sch, nRF54L15_qfaa_4L_config1.PcbDoc, nRF_beacon.kicad_pcb, nRF_beacon.kicad_sch]
2026-03-02 Began typical application around nPM1300
    [POWER.kicad_sch, nPM_example.kicad_pcb, nPM_example.kicad_sch, nRF_beacon.kicad_pcb, npm1300_qeaa_config1.kicad_pcb, npm1300_qeaa_config1.kicad_sch]
2026-03-03 Done a lot of work, connected all traces
    [AUDIO.kicad_sch, MCU.kicad_sch, nRF54L15_qfaa_4L_config1.PrjPCB, nRF54L15_qfaa_4L_config1.SchDoc, nRF_beacon.kicad_pcb]
2026-03-04 Cleaned up silkscreen
    [nRF_beacon.kicad_pcb, nRF_beacon.kicad_sch]
2026-03-04 Only 67 DRC errors left
    [nRF_beacon.kicad_pcb]
2026-03-06 Continued fixing DRC errors. Increased trace width on several lines
    [MCU.kicad_sch, nRF_beacon.kicad_pcb]
2026-03-07 Adjustments to GPIO connector. Added testpads. Polygon pour by antenna for correct impedance matching
    [AUDIO.kicad_sch, MCU.kicad_sch, POWER.kicad_sch, nRF_beacon.kicad_pcb, nRF_beacon.kicad_sch]
2026-03-07 Added stitching vias and completed DRC tests
    [AUDIO.kicad_sch, MCU.kicad_sch, POWER.kicad_sch, nRF_beacon.kicad_pcb, nRF_beacon.kicad_sch]
2026-03-07 Added silkscreen braille, blind person logo and revision
    [nRF_beacon.kicad_pcb]
2026-03-08 Completed layout for Revision A (Prototype). Created gerber files
    [BOM_nRF_AUDIO_BEACON.xlsx, MCU.kicad_sch, nRF_beacon.csv, nRF_beacon.kicad_pcb, nRF_beacon.kicad_sch, nRF_beacon.step, nRF_beacon.stl, nRF_beacon_BOM.xlsx]
