mathiasekse/IELS2003_PCB/(notices)

Notices in the files:
symbols_footprints/nPM1300-QEAA-Reference-Layout-1_2/Altium Designer files/npm1300_qeaa_config1/npm1300_qeaa_config1.kicad_sch:
© Nordic Semiconductor — All rights reserved.
